hapcan/UNIV_3.2.5.x/Readme.md

UNIV 3.2.5.x
============

RELAY MODULE - 6 monostable 6A relays

Device webpage: http://hapcan.com/devices/universal/univ_3/univ_3-2-5-x/

Hardware created in Eagle PCB Software http://www.cadsoftusa.com/

Firmware created in Microchip MPLAB http://www.microchip.com/mplabide/ in assembly language
