hapcan/UNIV_3.2.5.x/Hardware_UNIV_3.2.5.x/univ_3-2-5-x-rev4_label.docx

MONOSTABLE RELAY

6 CHANNEL
UN = 250V AC | | IN = 6A (IINRUSH = 10A)
TYPE | UNIV 3.2.5.x
S/N | 00000678h
BUS BUS | hapcan.com

PRZEKAŹNIK MONOSTABILNY

6 KANAŁOWY
UN = 250V AC | | IN = 6A (IROZRUCHOWY = 10A)
TYP | UNIV 3.2.5.x
S/N | 00000678h
BUS BUS | hapcan.com
