hapcan/UNIV_3.2.5.x/(commit log)

2017-03-05 hardware UNIV 3.2.5.x revision 4
    [pcb_univ_3-(2-7)-(5-0)-x-rev4.brd, pcb_univ_3-(2-7)-(5-0)-x-rev4.sch, univ_3-2-5-x-rev4.sch]
2017-05-03 firmware UNIV 3.2.5.0 revision 1
    [univ_3-2-5-0-rev1-memory.xlsx]
2018-11-25 firmware UNIV 3.2.5.0 revision 2
    [univ_3-2-5-0-rev2-memory.xlsx]
2022-10-31 firmware UNIV 3.2.5.0 revision 3
    [univ_3-2-5-0-rev3-memory.xlsx]
